FrancoRosa/static/(list of files, drawings)

Other design files:
EjercicioEstatico.pdsprj
