FrancoRosa/static/(commit log)

2021-11-14 Recover files from old project
    [AmericoEstimulador.pdsprj]
2024-02-29 Add materials to readme
    [EjercicioEstatico.pdsprj]
